skyphose/dicecase/counter-die/images/inlay_sides.png

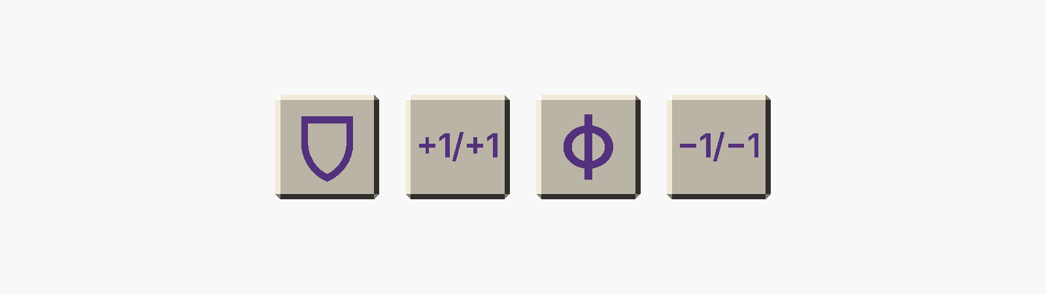
counter-die/images/inlay_sides.png
