skyphose/dicecase/images/1-Grid-closed.png

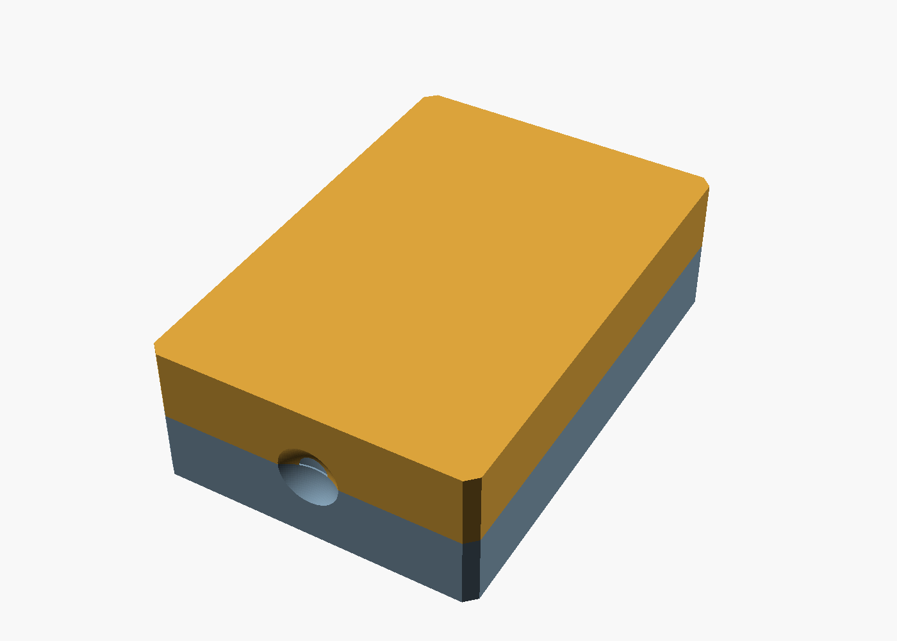
images/1-Grid-closed.png
