skyphose/dicecase/images/2-Row-closed.png

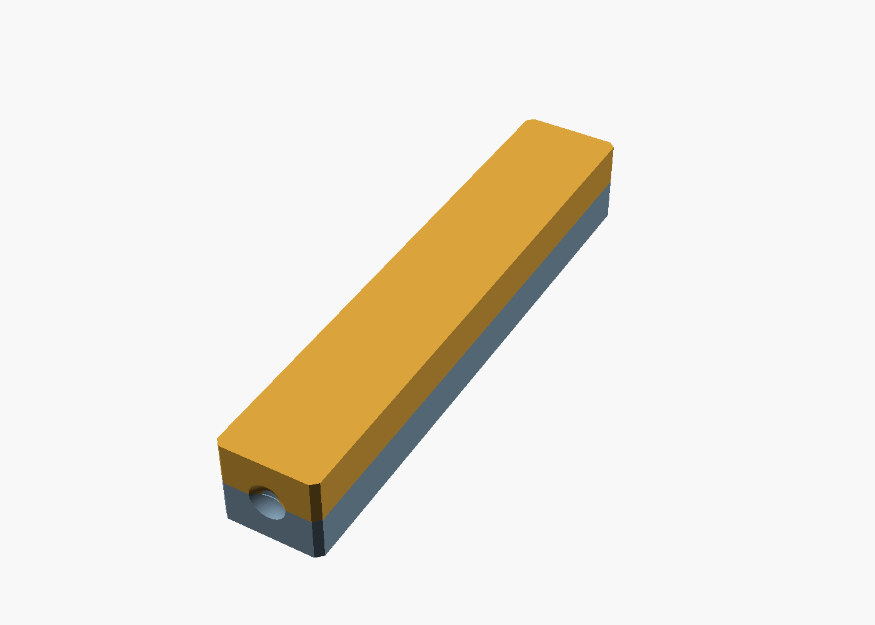
images/2-Row-closed.png
