skyphose/dicecase/images/3-Mixed-closed.png

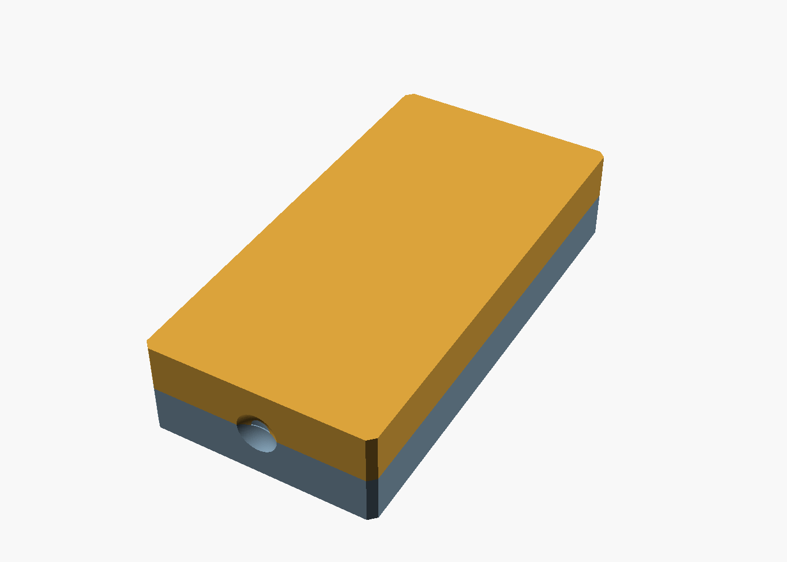
images/3-Mixed-closed.png
