skyphose/dicecase/preview_row_open.png

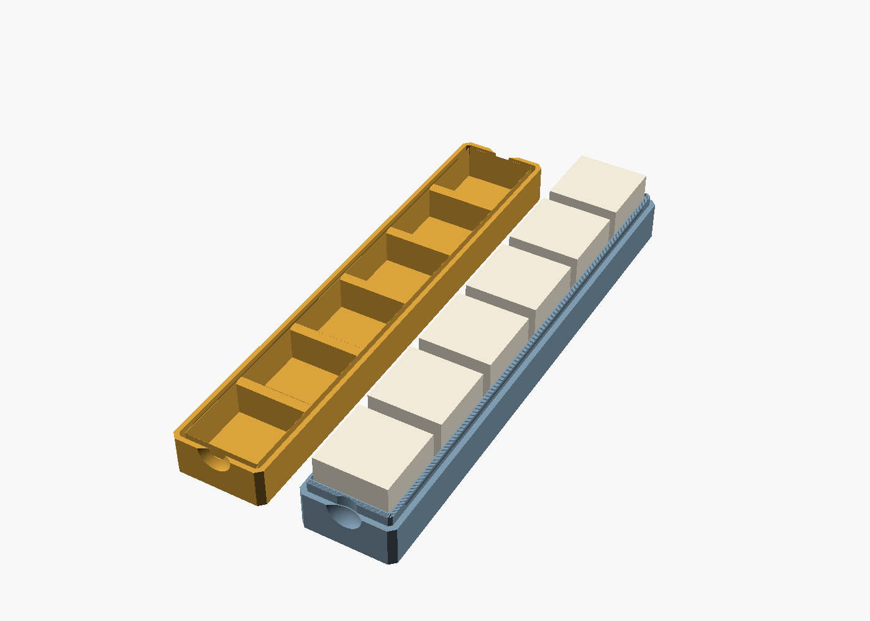
preview_row_open.png
