skyphose/dicecase/3mf/Dicecase_Row_1-bottom.3mf

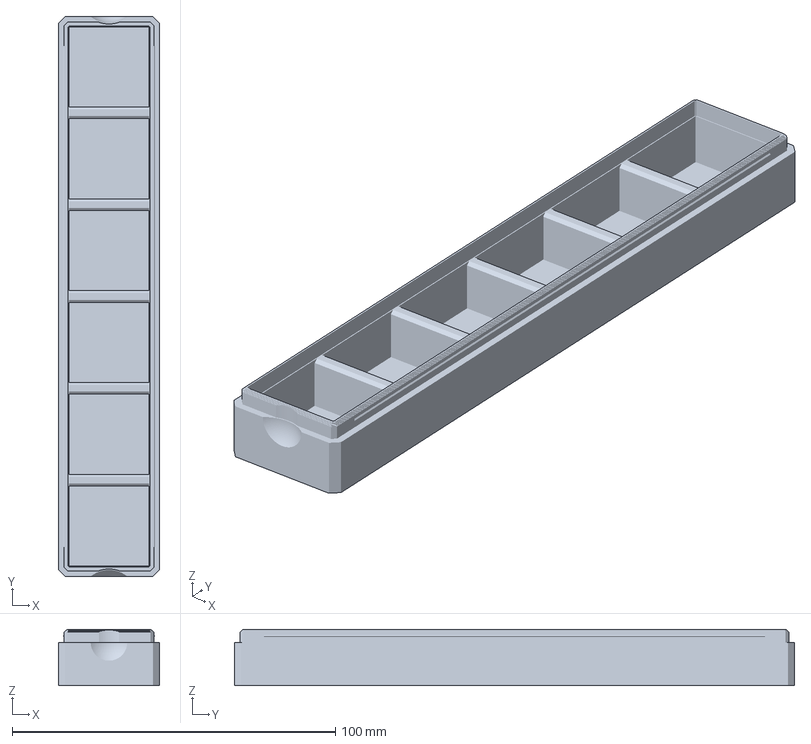
[picture p12: CAD file, 2026-10-19]
3mf/Dicecase_Row_1-bottom.3mf
31.2 x 173.2 x 17.4 mm
