skyphose/dicecase/counter-die/3mf/counter_die_shell_bottom.3mf

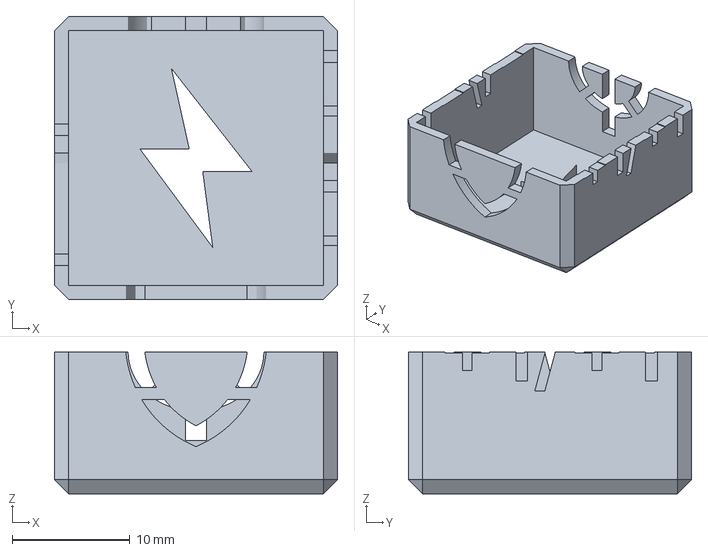
[picture p13: CAD file, 2026-10-18]
counter-die/3mf/counter_die_shell_bottom.3mf
24.0 x 24.0 x 12.0 mm
