skyphose/dicecase/3mf/Dicecase_Mixed_2-top.3mf

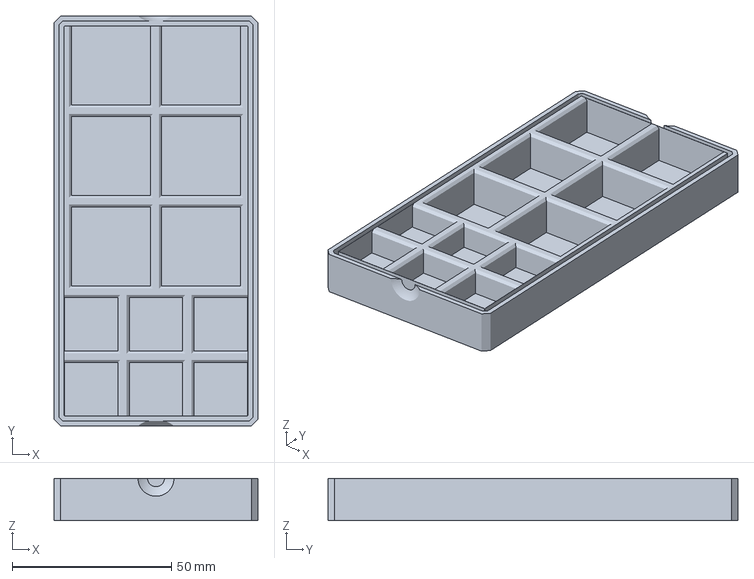
[picture p14: CAD file, 2026-10-19]
3mf/Dicecase_Mixed_2-top.3mf
64.0 x 128.8 x 13.3 mm
