skyphose/dicecase/3mf/Dicecase_Grid_2-top.3mf

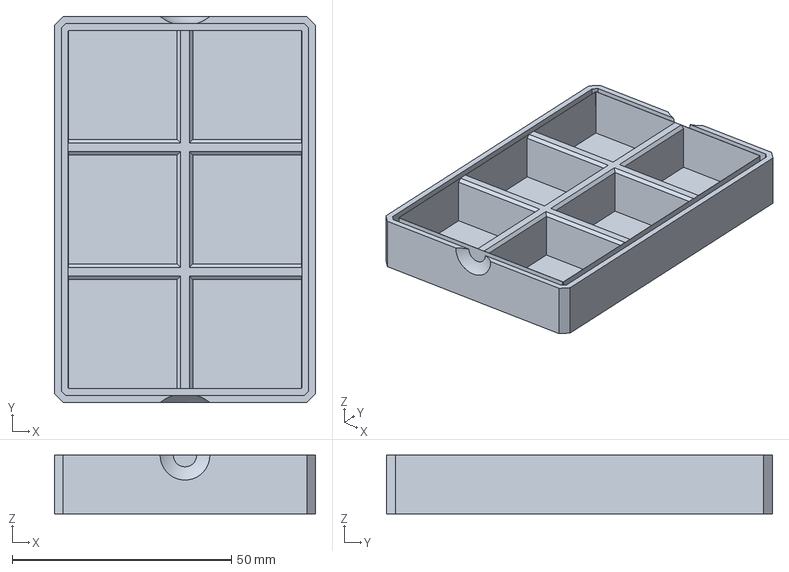
[picture p16: CAD file, 2026-10-19]
3mf/Dicecase_Grid_2-top.3mf
59.6 x 88.0 x 13.3 mm
