skyphose/dicecase/3mf/Dicecase_Grid_1-bottom.3mf

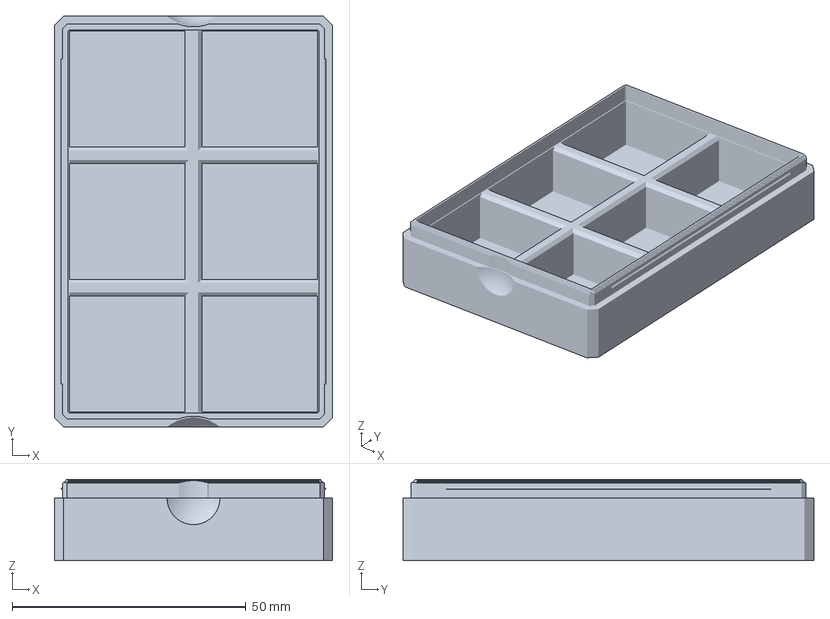
[picture p17: CAD file, 2026-10-19]
3mf/Dicecase_Grid_1-bottom.3mf
59.6 x 88.0 x 17.4 mm
