skyphose/dicecase/counter-die/3mf/counter_die_inlay.3mf

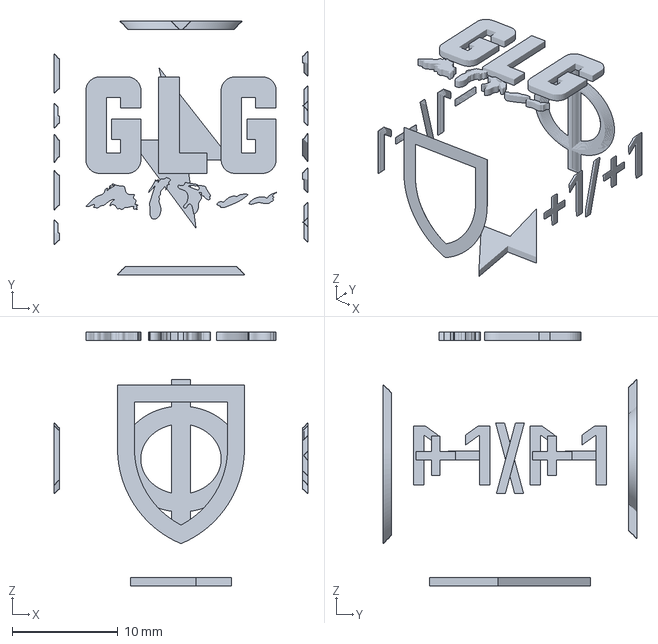
[picture p18: CAD file, 2026-10-18]
counter-die/3mf/counter_die_inlay.3mf
24.0 x 24.0 x 24.0 mm
