skyphose/dicecase/3mf/Dicecase_Mixed_1-bottom.3mf

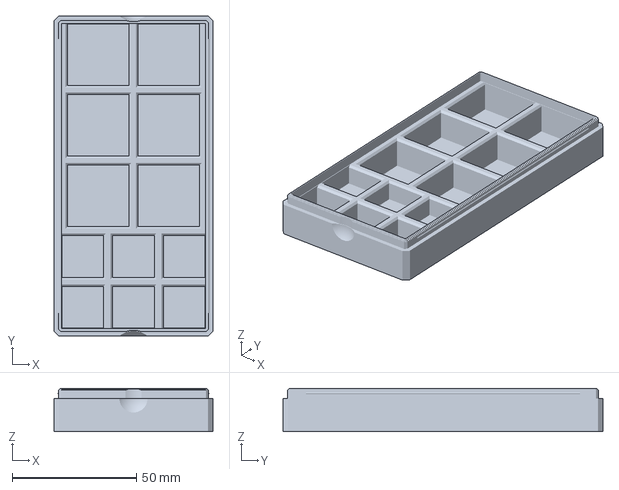
[picture p19: CAD file, 2026-10-19]
3mf/Dicecase_Mixed_1-bottom.3mf
64.0 x 128.8 x 17.4 mm
