skyphose/dicecase/counter-die/3mf/counter_die_core.3mf

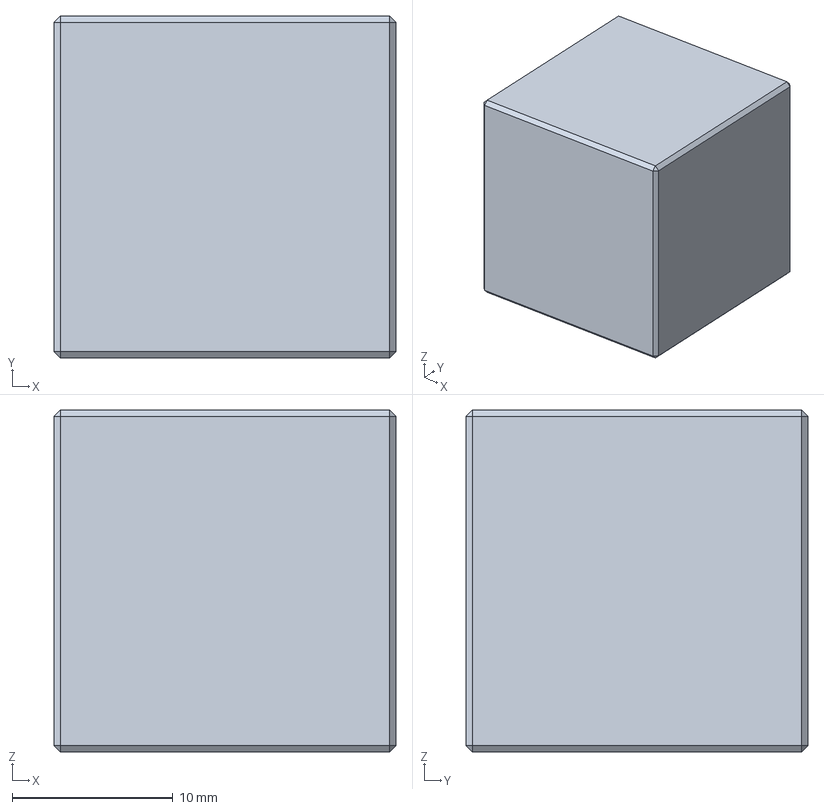
[picture p20: CAD file, 2026-10-18]
counter-die/3mf/counter_die_core.3mf
21.3 x 21.3 x 21.3 mm
