skyphose/dicecase/3mf/Dicecase_Row_2-top.3mf

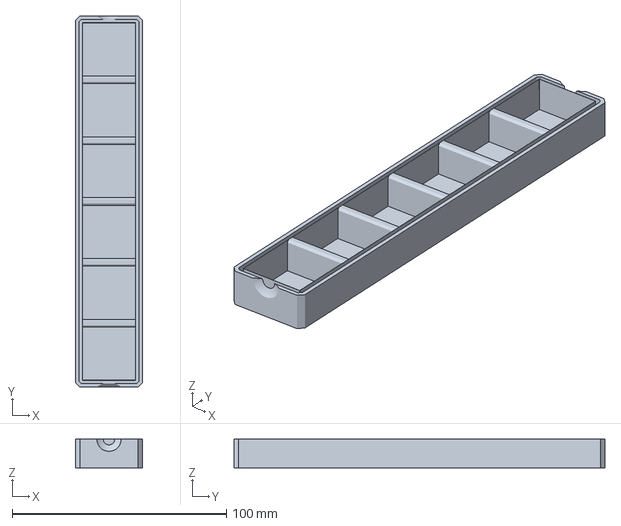
[picture p21: CAD file, 2026-10-19]
3mf/Dicecase_Row_2-top.3mf
31.2 x 173.2 x 13.3 mm
