skyphose/dicecase/(list of files, cad)

Other CAD files:
counter-die/3mf/counter_die_shell_top.3mf
3mf/mixed_bottom.3mf
3mf/mixed_top.3mf
3mf/grid_top.3mf
3mf/row_bottom.3mf
3mf/grid_bottom.3mf
3mf/row_top.3mf
counter-die/stl/counter_die_body.stl
counter-die/stl/counter_die_core.stl
counter-die/stl/counter_die_inlay.stl
counter-die/stl/counter_die_mono.stl
counter-die/stl/counter_die_shell_bottom.stl
counter-die/stl/counter_die_shell_top.stl
stl/Dicecase_Grid_1-bottom.stl
stl/Dicecase_Grid_2-top.stl
stl/Dicecase_Mixed_1-bottom.stl
stl/Dicecase_Mixed_2-top.stl
stl/Dicecase_Row_1-bottom.stl
stl/Dicecase_Row_2-top.stl
stl/grid_bottom.stl
stl/grid_top.stl
stl/mixed_bottom.stl
stl/mixed_top.stl
stl/row_bottom.stl
stl/row_top.stl
