skyphose/dicecase/(commit log)

2026-10-17 dicecase: a two-piece snap-shut clamshell for six 24 mm d6
    two halves split at the dice midline. a rim on the bottom clicks into a rebate in
    the top, beaded along both long sides, so theres no hardware and no magnets. the
    dice are the second register: each sits half in each half, so a closed case cant
    shear, and an open one leaves every die standing 12 mm proud. two layouts, grid
    (2 x 3, 59.6 x 88 x 26.7 mm) and row (6 in a line, 31.2 x 173.2 x 26.7 mm).
    it started as a deckblock-style sliding lid and went through a hinged clamshell
    on a filament pin. the hinge was dropped after a test print, the pin clearance
    didnt work, and neither earlier version is in this repo.
    verified: all four part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
2026-10-18 counter-die: a 24 mm counter d6 for the sixth pocket, in three colourings
    counter symbols instead of pips: +1/+1 and -1/-1, poison and shield, the glg
    logo and an energy bolt. every face is one line in `faces`, so the set is easy
    to change. three versions, one per way you colour it:
    mono is a cameo that reads in one filament with no paint. each face is a panel
    sunk 1 mm with the symbol standing back up inside it, so the pocket throws a
    shadow round every symbol. only the edges that overhang in print are ramped at
    45 deg, the pocket's top and each stroke's bottom. the first cut ramped every
    edge and merged the +1/+1 into a blob under a low light.
    inlay is the engraved die, for an ams or for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
2026-10-19 mixed layout: six 24 mm dice and six 16 mm deckblock dice in one case
    d6() takes a size now, and every pocket carries its own depth. each die still
    sits half in each shell, centred on the parting plane, so a 16 mm die in a case
    sized for 24 mm ones gets an 8.15 mm pocket and a thicker floor under it. the
    case height is still set by the deepest pocket.
    mixed is three rows of two big dice over two rows of three small ones, 64 x
    128.8 x 26.7 mm. the thick floor under the small dice makes it about twice
    the plastic of grid, so print it at 15% infill.
    verified: both mixed halves closed and manifold, 0.00 mm2 unsupported, and the
    closed halves intersect for 0.000 mm3. grid and row come out at th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
2026-10-19 frame grid, row and mixed as dicecase variants
    the readme leads with the three variants now, the way deckblock does, and they
    answer the same question: what are you carrying. one table of what each holds
    and its size, then a section and a picture per variant. the rim, the bead, the
    thumb dishes and the depth budget stay shared below that, because a fix to one
    is a fix to all three.
    the models are named so they sort into print order, as deckblock's are:
    Dicecase_<Variant>_1-bottom and _2-top, in stl/ and 3mf/. the previews moved to
    images/<n>-<Variant>-{open,closed}.png in the order the readme shows them.
    build_all.sh writes the 3mfs as well as the stls, so nothing is exported by
    hand any mo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
